natalialoprom/DIGIFAB/experiments/oranges/raw_data.csv

ms | phase | tempC | humPct | pressHpa | gasKOhms | deltaGasKOhms | gasDropPct | deltaHumPct
368 | ambient | 27.79 | 27.45 | 1002.32 | 19.75 | 0.00 | 0.00 | 0.00
2737 | ambient | 27.42 | 26.95 | 1002.33 | 18.87 | 0.00 | 0.00 | 0.00
5106 | ambient | 27.12 | 26.83 | 1002.35 | 18.53 | 0.00 | 0.00 | 0.00
7475 | ambient | 26.88 | 26.82 | 1002.35 | 18.37 | 0.00 | 0.00 | 0.00
9844 | ambient | 26.70 | 26.85 | 1002.35 | 18.45 | 0.00 | 0.00 | 0.00
12213 | ambient | 26.56 | 26.87 | 1002.36 | 18.35 | 0.00 | 0.00 | 0.00
14582 | ambient | 26.46 | 26.89 | 1002.37 | 18.50 | 0.00 | 0.00 | 0.00
16951 | ambient | 26.38 | 26.88 | 1002.37 | 18.48 | 0.00 | 0.00 | 0.00
19320 | ambient | 26.31 | 26.87 | 1002.35 | 18.58 | 0.00 | 0.00 | 0.00
21689 | ambient | 26.27 | 26.84 | 1002.35 | 18.58 | 0.00 | 0.00 | 0.00
24068 | ambient | 26.23 | 26.83 | 1002.33 | 18.64 | 0.00 | 0.00 | 0.00
26437 | ambient | 26.20 | 26.82 | 1002.33 | 18.81 | 0.00 | 0.00 | 0.00
28806 | ambient | 26.18 | 26.82 | 1002.33 | 18.92 | 0.00 | 0.00 | 0.00
31175 | ambient | 26.16 | 26.88 | 1002.33 | 18.94 | 0.00 | 0.00 | 0.00
33544 | ambient | 26.15 | 26.93 | 1002.32 | 18.99 | 0.00 | 0.00 | 0.00
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
