natalialoprom/DIGIFAB/experiments/oranges/summary_stats.csv

segment | n | duration_s | metric | mean | std | min | max
ambient_ref | 22 | 49.748999999999796 | tempC | 26.007727272727276 | 0.01066003581778058 | 25.98 | 26.02
ambient_ref | 22 | 49.748999999999796 | humPct | 26.57045454545454 | 0.16243613463604067 | 26.51 | 27.26
ambient_ref | 22 | 49.748999999999796 | gasKOhms | 32.463181818181816 | 0.31390605758253987 | 31.36 | 32.84
ambient_ref | 22 | 49.748999999999796 | deltaGasKOhms | 0.2636363636363636 | 0.31368084257039186 | -0.84 | 0.64
ambient_ref | 22 | 49.748999999999796 | gasDropPct | -0.818181818181818 | 0.9703933241027596 | -1.98 | 2.59
ambient_ref | 22 | 49.748999999999796 | deltaHumPct | 0.0790909090909091 | 0.16291713029019184 | 0.02 | 0.77
fresh_oranges | 294 | 694.1169999999997 | tempC | 24.27465986394558 | 0.5162033754909404 | 23.88 | 25.97
fresh_oranges | 294 | 694.1169999999997 | humPct | 30.836496598639457 | 1.051360067463078 | 27.76 | 32.26
fresh_oranges | 294 | 694.1169999999997 | gasKOhms | 30.91772108843538 | 0.8807520311488771 | 29.1 | 33.04
fresh_oranges | 294 | 694.1169999999997 | deltaGasKOhms | -1.2818367346938775 | 0.8806106478945197 | -3.1 | 0.84
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
