natalialoprom/DIGIFAB/experiments/oranges/figures/plot_boxes.png

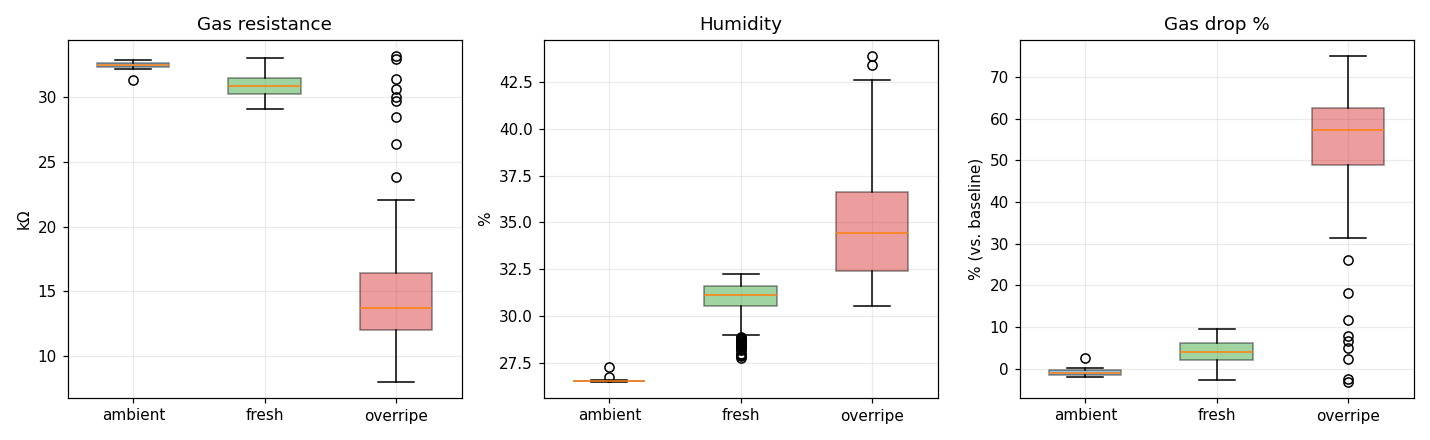
experiments/oranges/figures/plot_boxes.png
