natalialoprom/DIGIFAB/experiments/oranges/figures/plot_gas.png

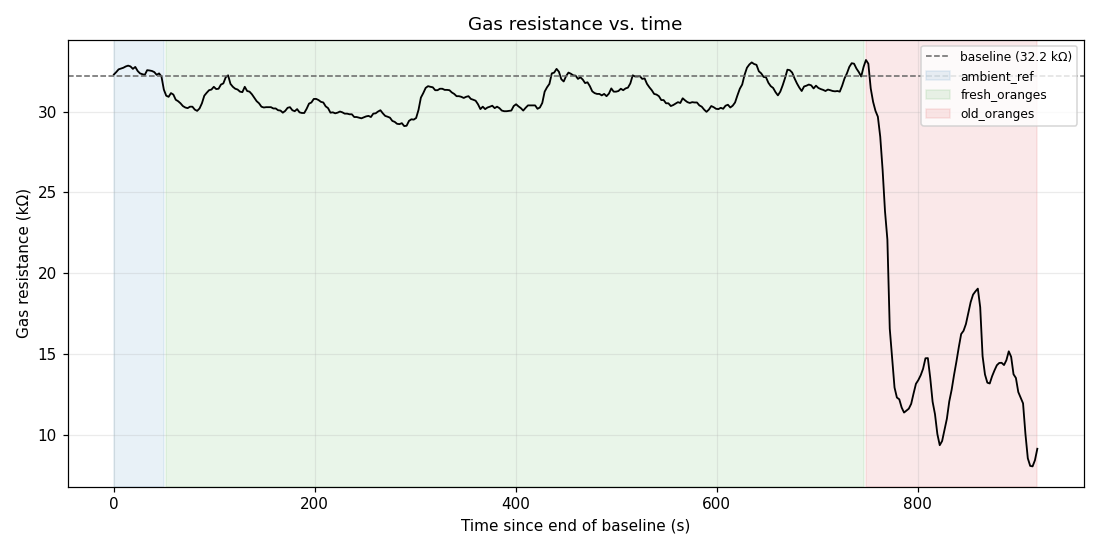
experiments/oranges/figures/plot_gas.png
