natalialoprom/DIGIFAB/experiments/oranges/figures/plot_hum.png

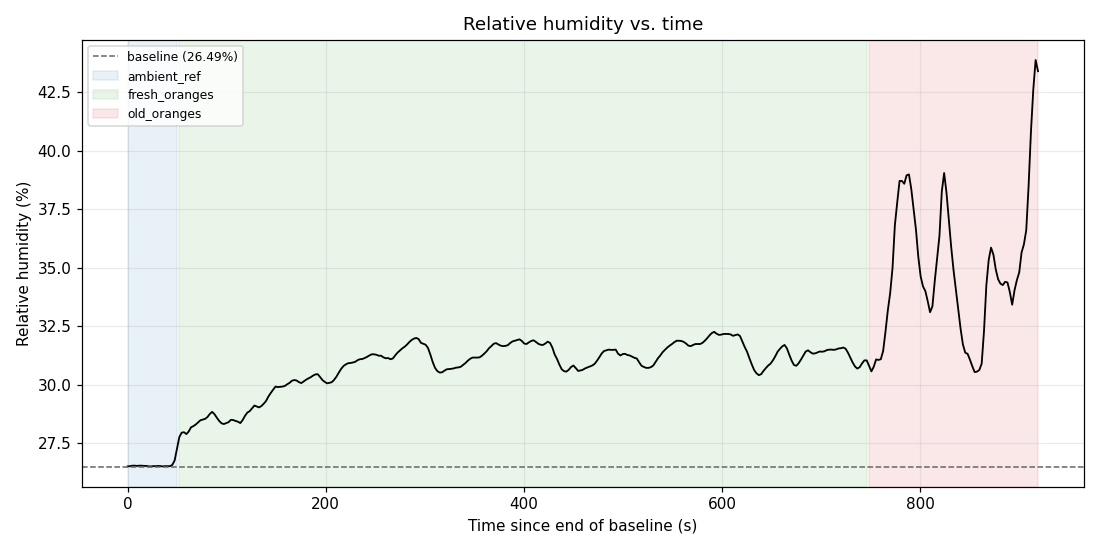
experiments/oranges/figures/plot_hum.png
