natalialoprom/DIGIFAB/experiments/oranges/figures/plot_temp.png

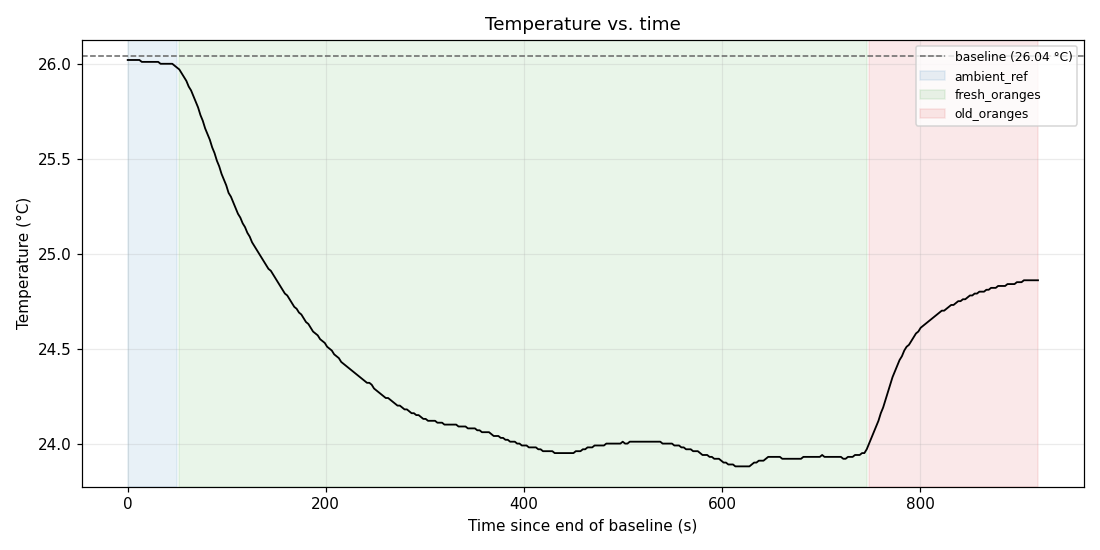
experiments/oranges/figures/plot_temp.png
