natalialoprom/DIGIFAB/(commit log)

2026-05-02 Initial project structure and prototype files
    [raw_data.csv, summary_stats.csv]
2026-05-05 Update docs, prototype instructions, calibration and Raspberry Pi setup
